esquiree/Raspberry_Pi_Hat/Temple_RPi_HAT Rev 3.1/JLCSMT_Sample_BOM1 (1).xlsx

Comment | Designator | Footprint | LCSC Part #（optional）
0.01uF | C6 C7 C14 C15 C16 C21 C24 C29 | C_0603 | C57112
0.1uF | C1 C4 C5 C13 C22 C25 C28 | C_0603 | C14663 (https://lcsc.com/product-detail/Multilayer-Ceramic-Capacitors-MLCC-SMD-SMT_100nF-104-10-50V_C14663.html/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)
1uF | C2 C3 C8 C9 C12 C17 C18 C19 C20 C23 C26 C27 | C_0603 | C15849 (https://lcsc.com/product-detail/Multilayer-Ceramic-Capacitors-MLCC-SMD-SMT_SAMSUNG_CL10A105KB8NNNC_1uF-105-10-50V_C15849.html/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)
47uF | C10 C11 | CP_Elec_5x5.3 | C134798
D | D4 D5 D8 | D_SMA | C22452
LED | D1 D2 D3 D6 D7 D9 D10 D11 | LED_0805 | C2297
Polyfuse | F1 | R_1812 | C69689
1.5K | R29 R34 | R_0603 | C21190
10 | R48 | R_0603 | C22773
100K | R44 | R_0603 | C23266 (https://lcsc.com/product-detail/Chip-Resistor-Surface-Mount_UNI-ROYAL-Uniroyal-Elec-0603WAF9312T5E_C23266.html)
13.5K | R31 | R_0603 | C25952
1K | R1 R2 R3 R4 R5 R8 R35 R37 R38 R39 R40 R41 R42 R43 R46 R47 | R_0603 | C21190
200K | R30 R32 R45 | R_0603 | C8218
27K | R33 | R_0603 | C22967
2K | R36 | R_0603 | C22975
AZ1117-3.3 | U8 | SOT-223-3_TabPin2 | C369933
BQ24092DGQR | U6 | MSOP-10-1EP_3x3mm_Pitch0.5mm | C133237
DRV8833RTYR | U9 U10 | WQFN-16-1EP_4x4mm_Pitch0.65mm_ThermalVias | C154936
LMV321 | U7 | SOT-23-5 | C7972
LSM6DS3 | U1 | Bosch_LGA-16 | C95231 (https://lcsc.com/product-detail/Sensors_STMicroelectronics_LSM6DS33TR_LSM6DS33TR_C95231.html/?href=jlc-SMT)
SY7304DBC | U4 U5 | DFN-10-1EP_3x3mm_Pitch0.5mm | C178252
