esquiree/Raspberry_Pi_Hat/Temple_RPi_HAT Rev 3.1/Temple_RPi_HAT.pdf

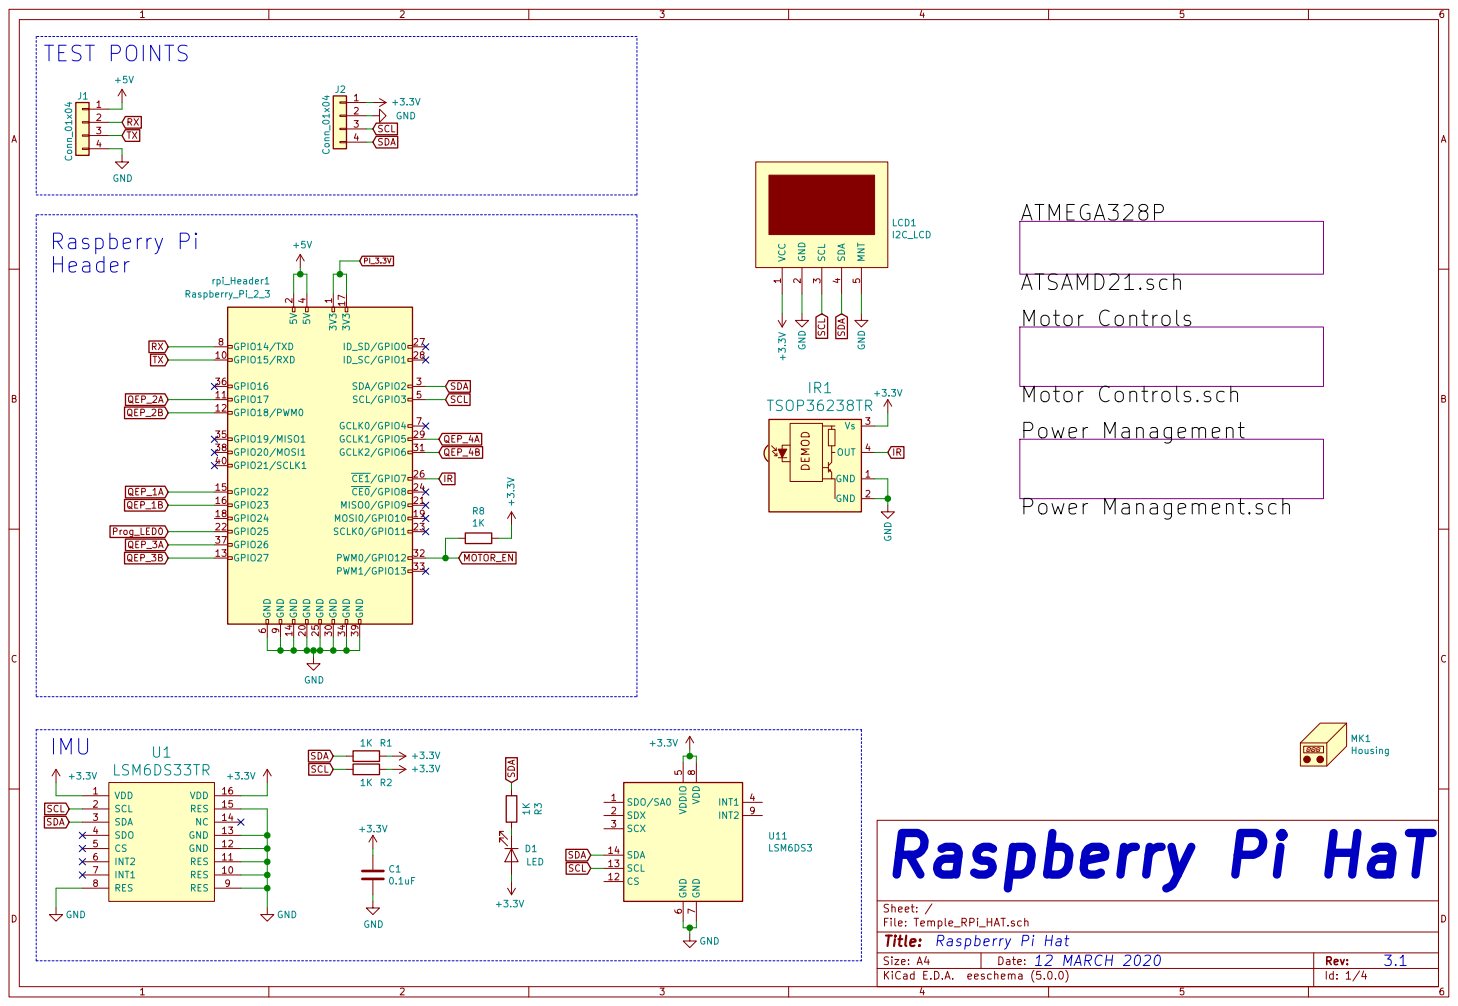
[picture p1: page 1]

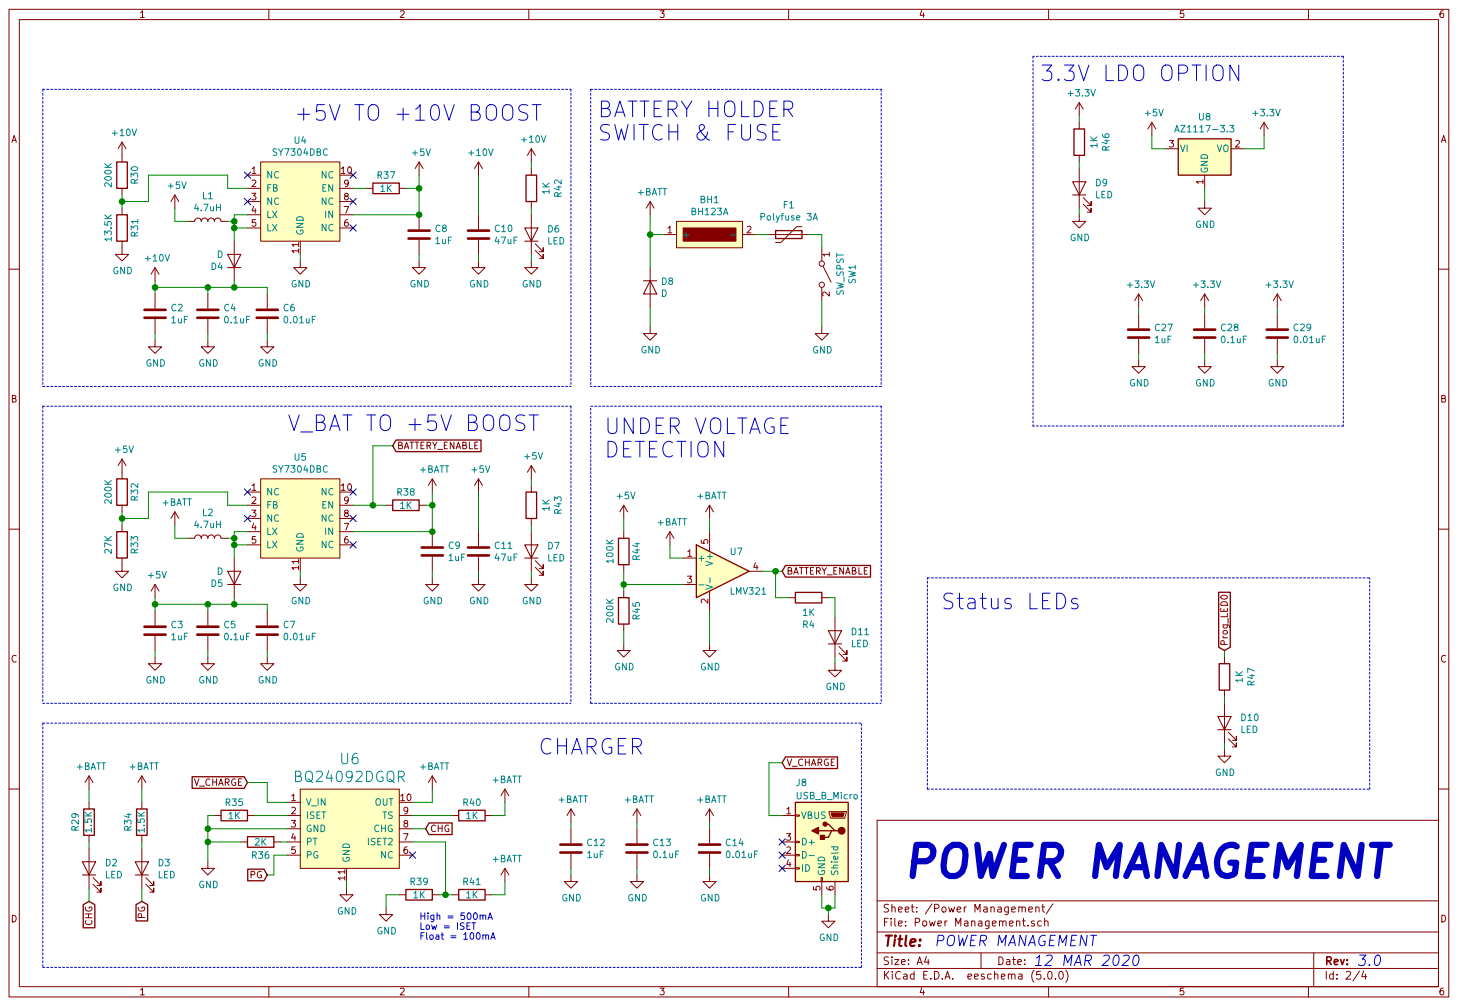
[picture p2: page 2]

Sheet: /Power Management/
File: Power Management.sch
POWER MANAGEMENT

High = 500mA

12 MAR 2020

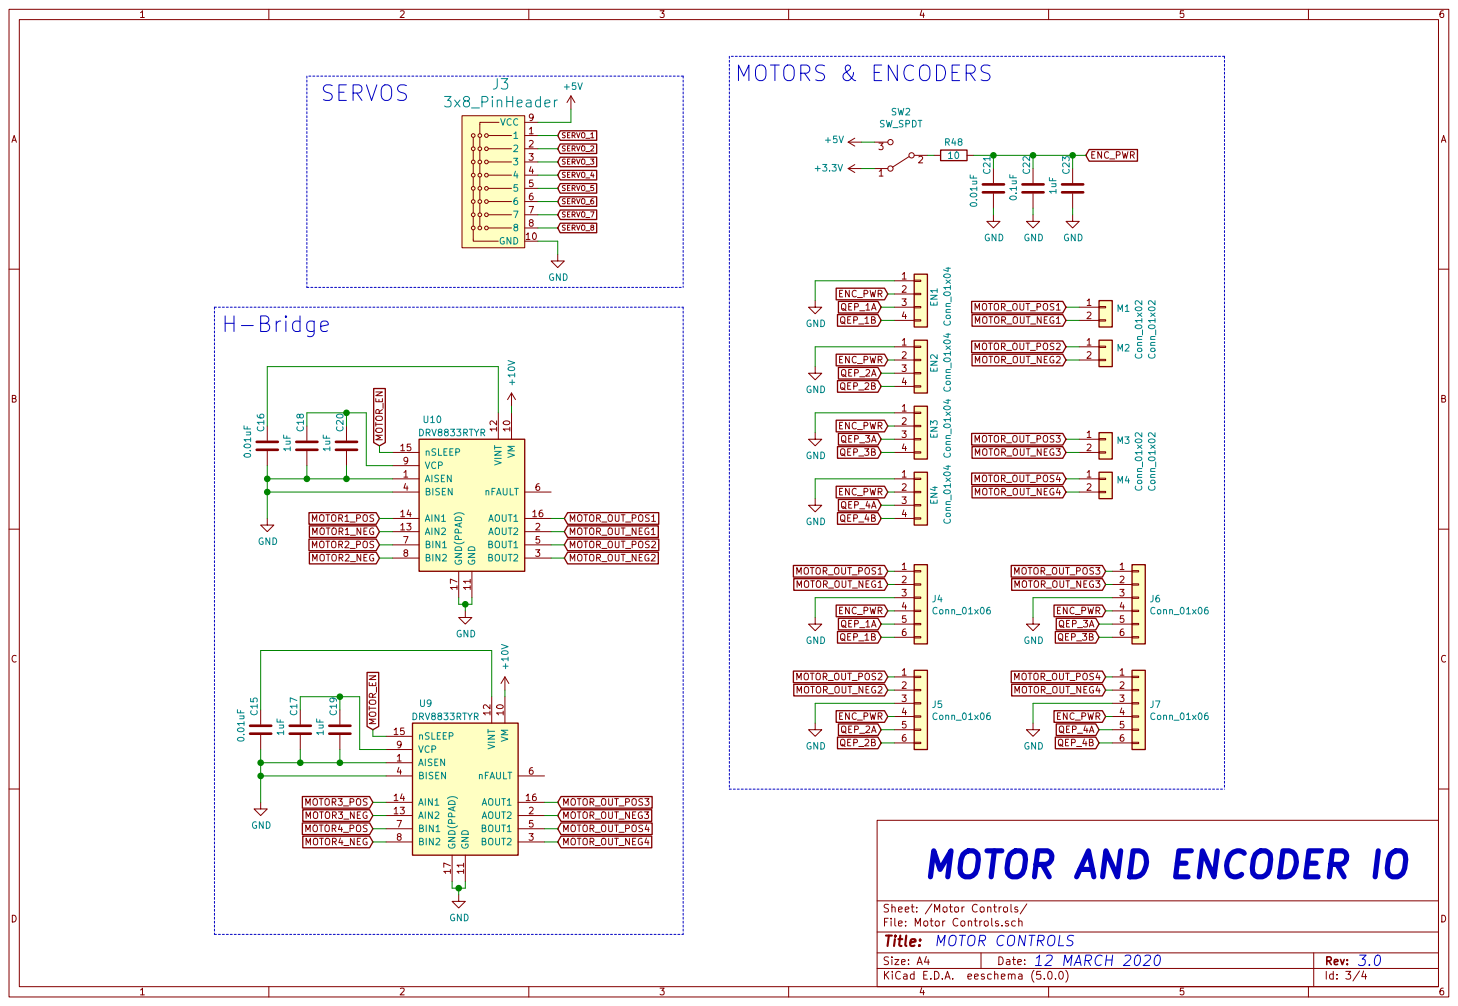
[picture p3: page 3]

MOTOR AND ENCODER IO

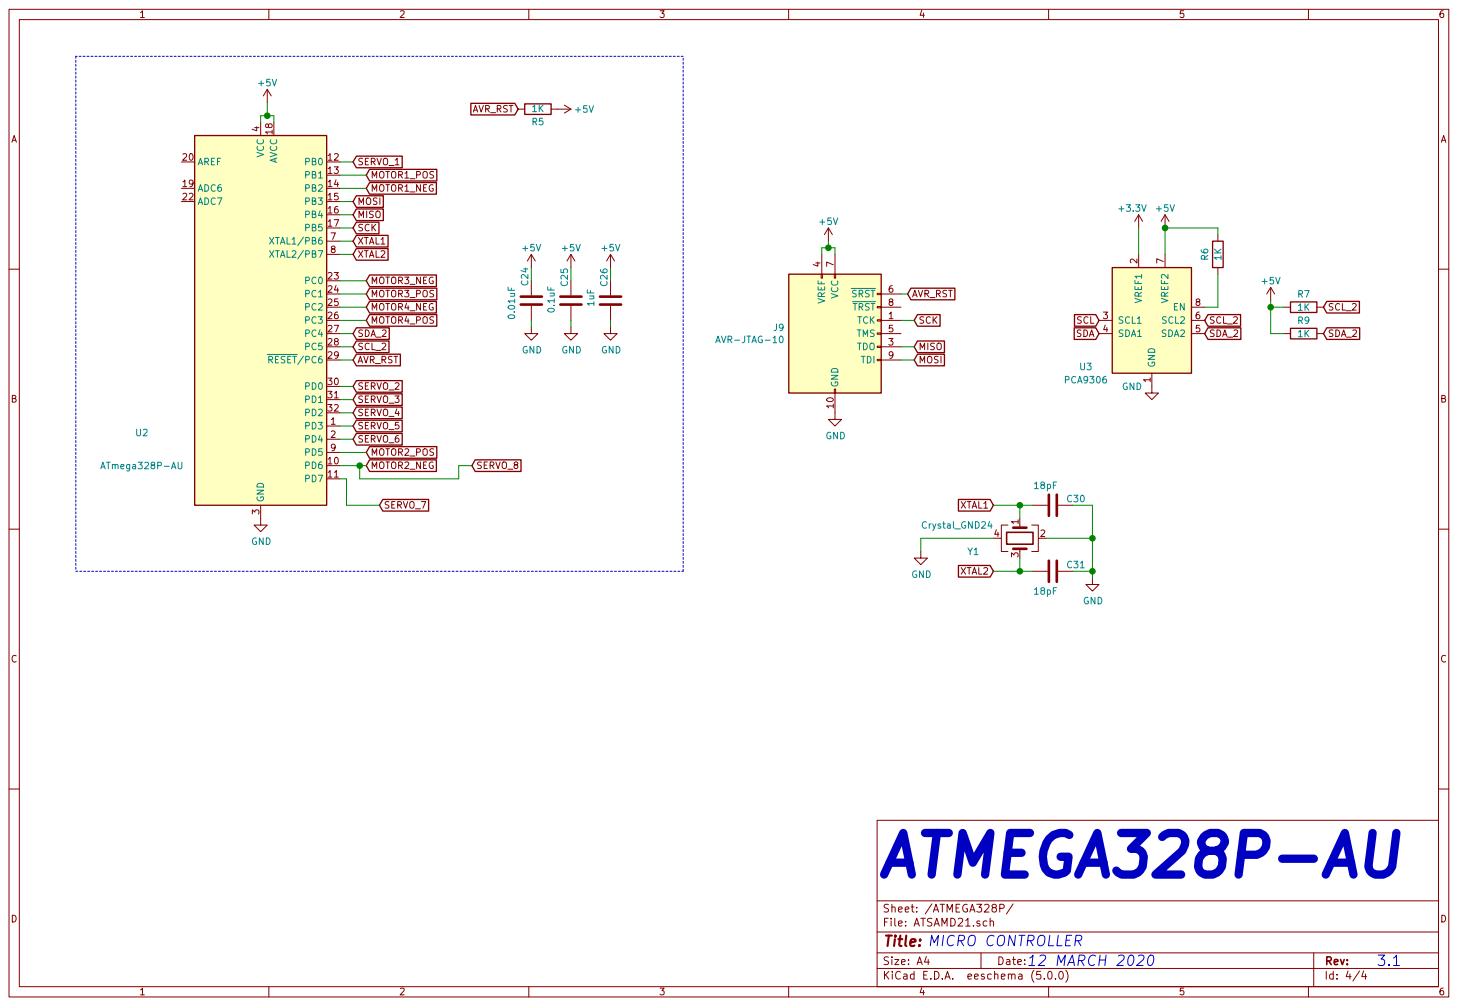
[picture p4: page 4]

Id: 4/4 Title: File: ATSAMD21.sch Sheet: /ATMEGA328P/
MICRO CONTROLLER
