esquiree/Raspberry_Pi_Hat/Temple_RPi_HAT Rev 3.0/Temple_RPi_HAT.pdf

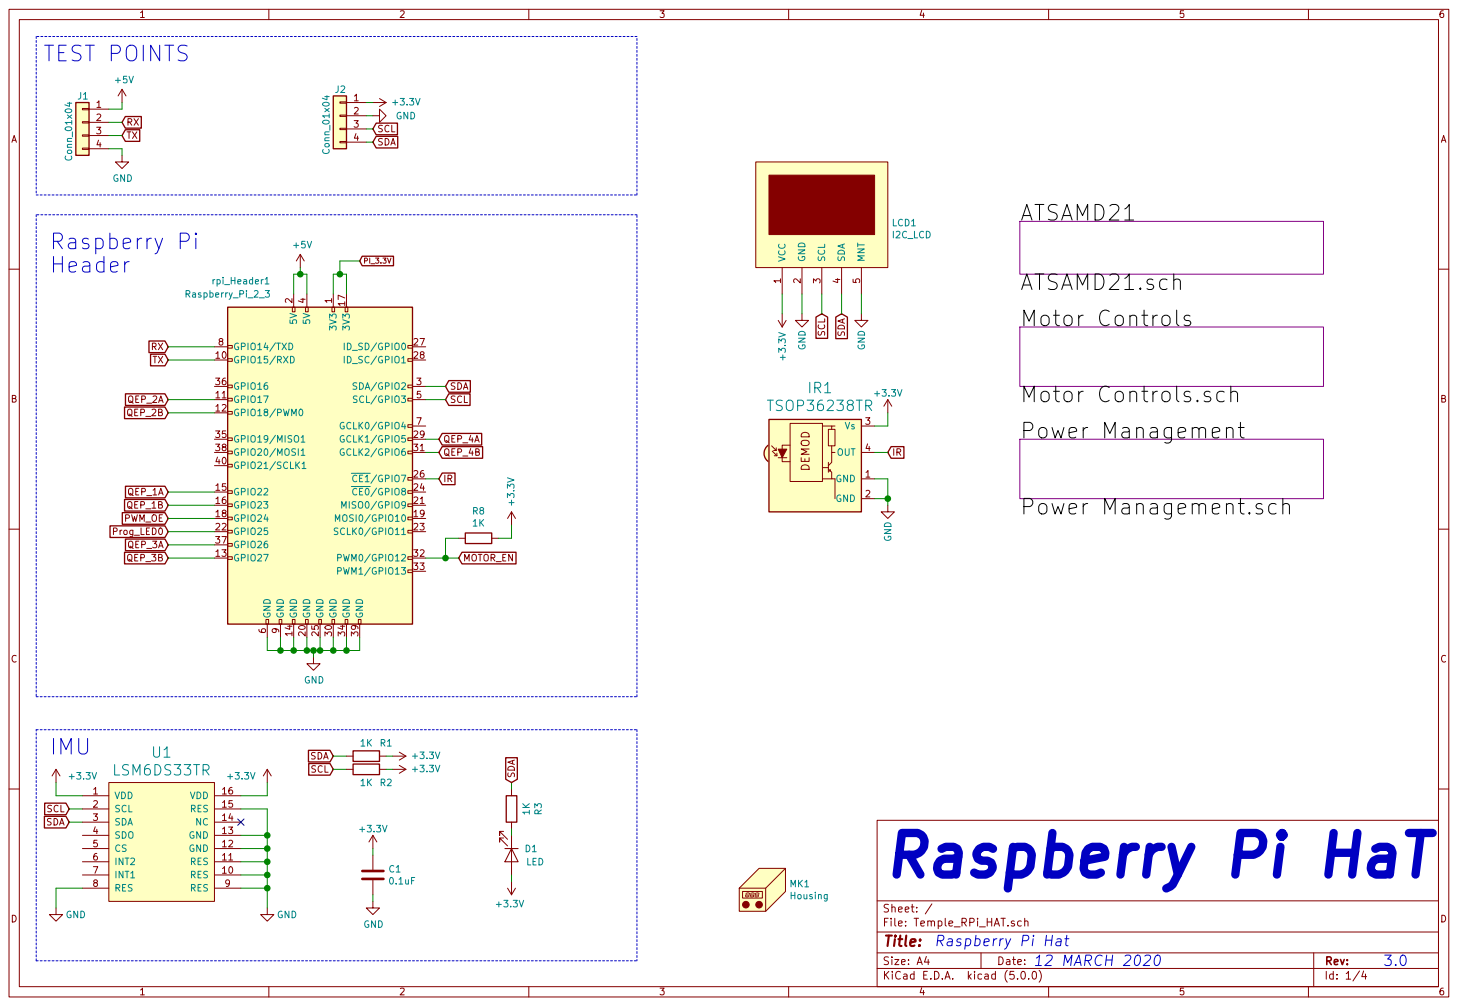
[picture p5: page 1]

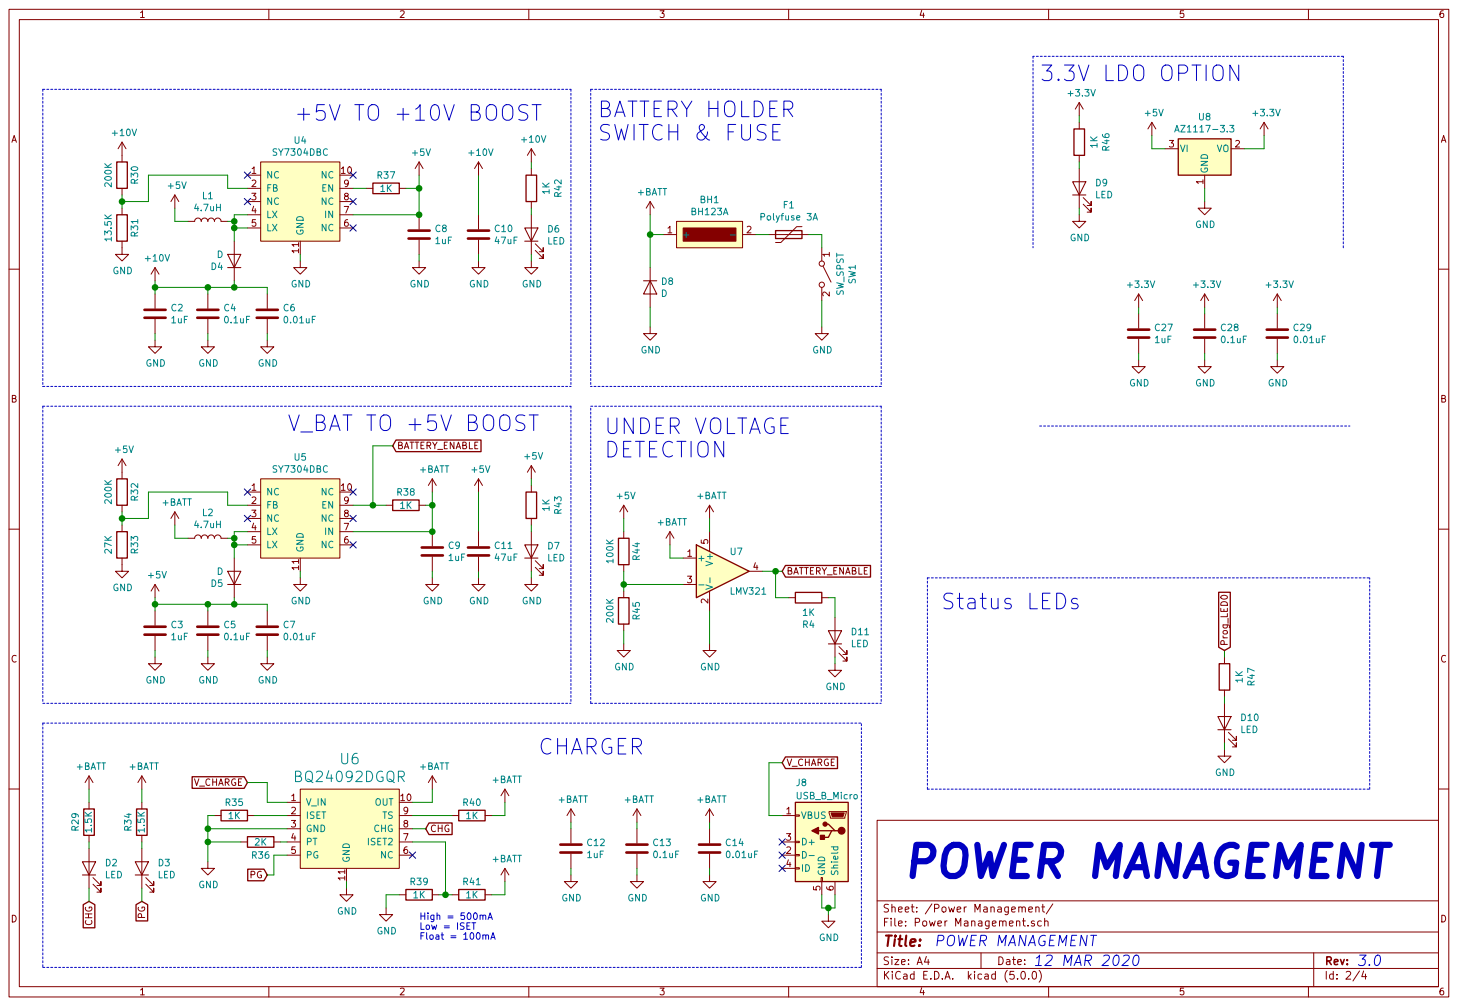
[picture p6: page 2]

Sheet: /Power Management/
File: Power Management.sch
POWER MANAGEMENT

High = 500mA

12 MAR 2020

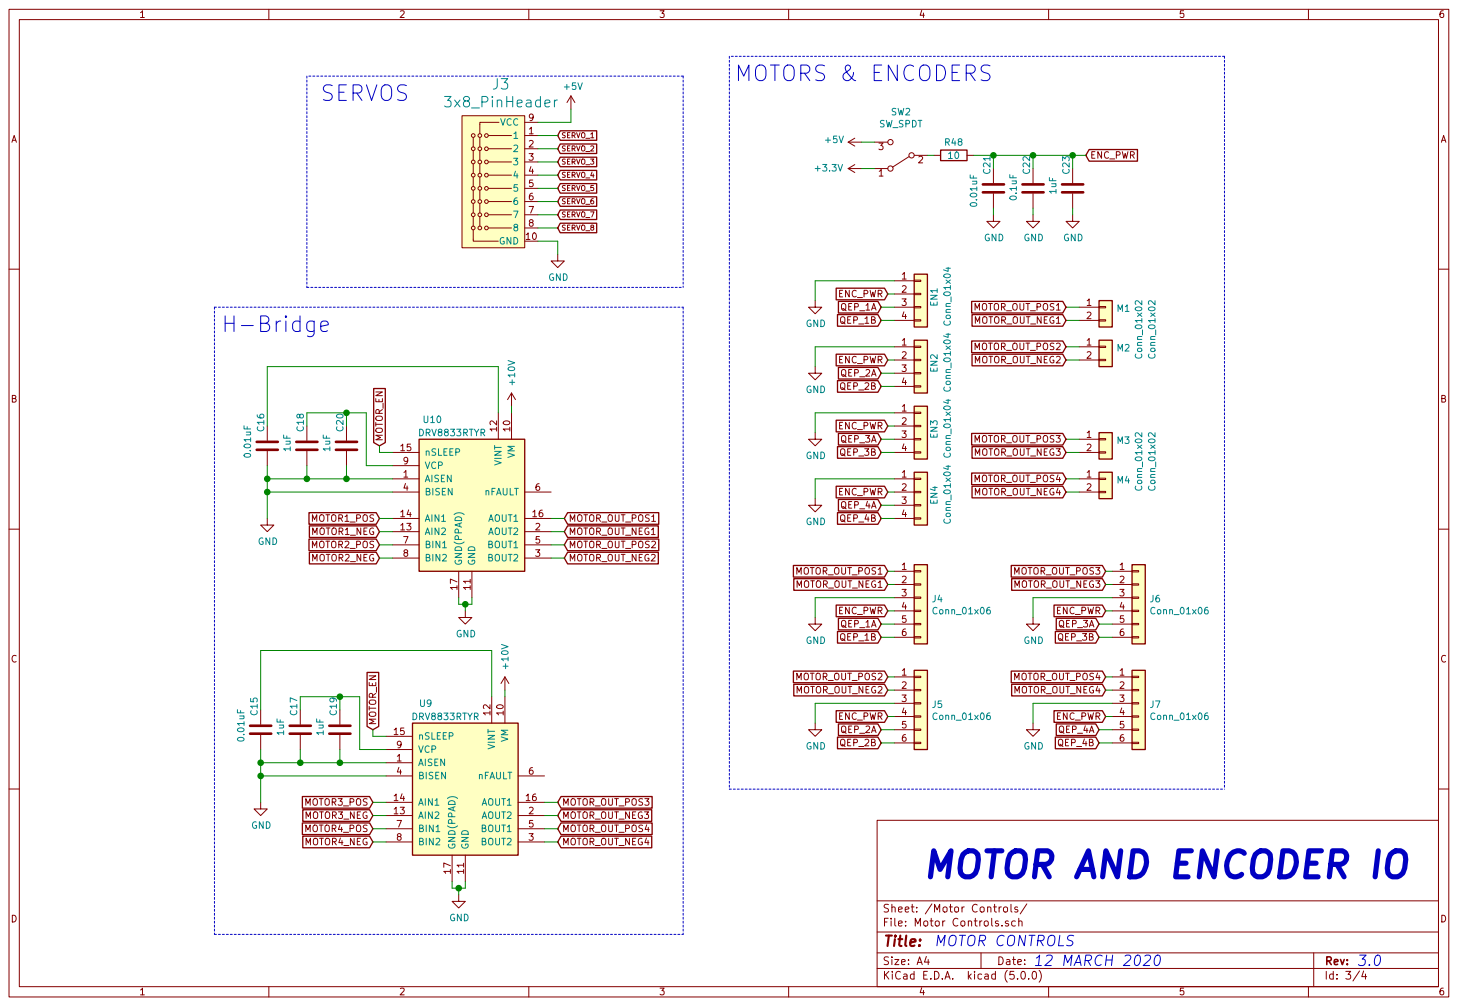
[picture p7: page 3]

MOTOR AND ENCODER IO

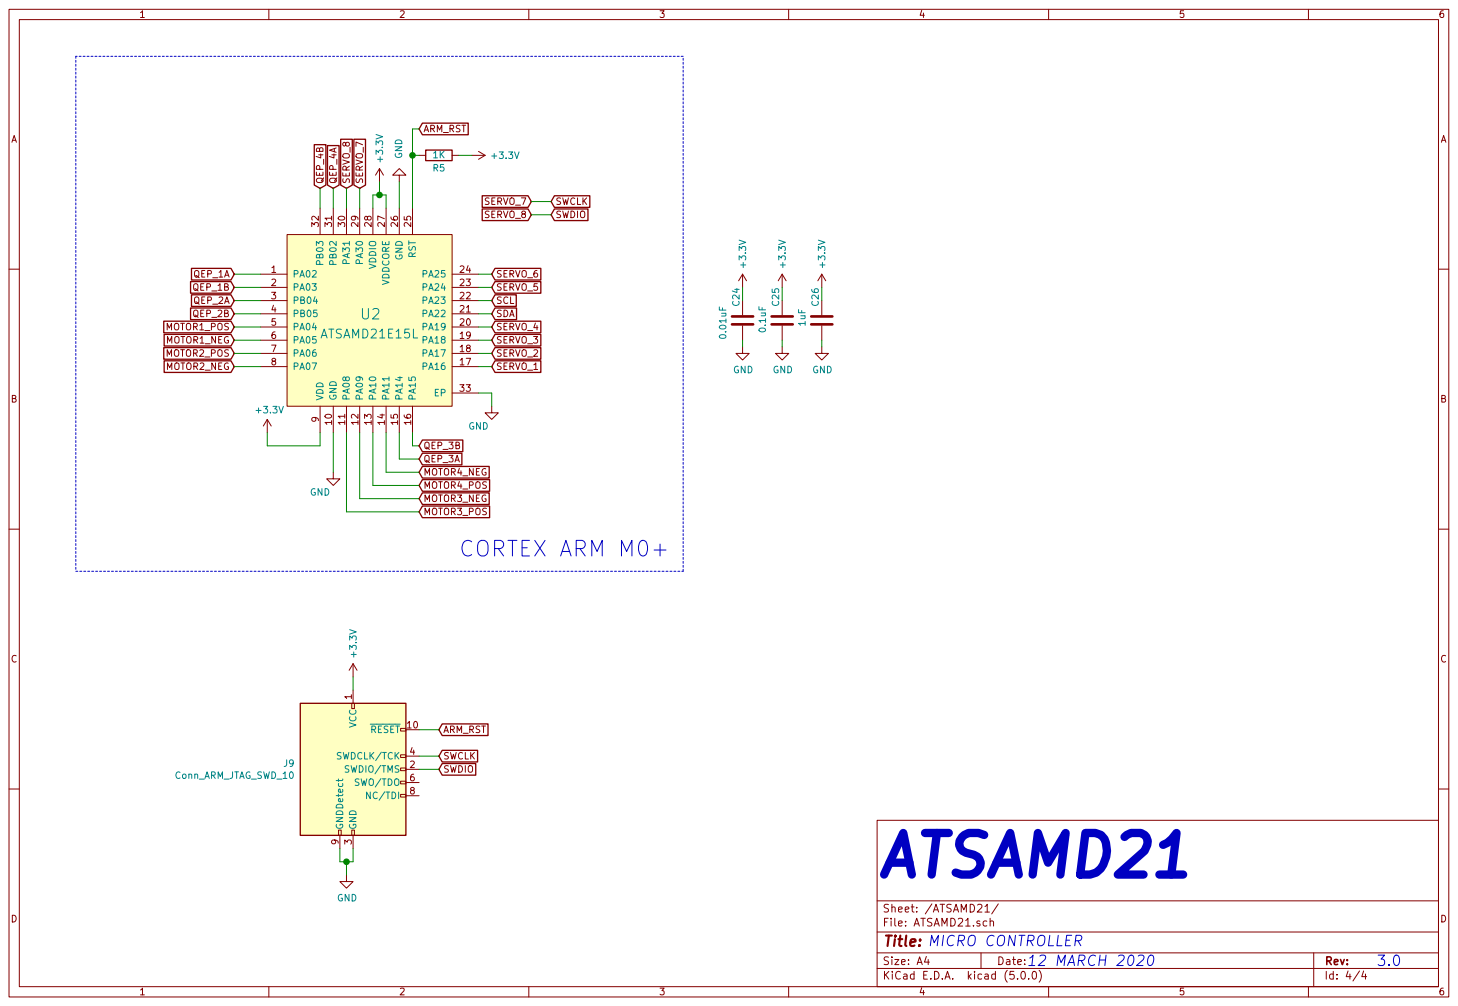
[picture p8: page 4]

1 RESET 10 SWDIO/TMS 2 GND

3 SWDCLK/TCK 4 SWO/TDO 6 NC/TDI 8 GNDDetect 9

Id: 4/4 Title: File: ATSAMD21.sch Sheet: /ATSAMD21/
MICRO CONTROLLER
