esquiree/Raspberry_Pi_Hat/Temple_RPi_HAT Rev 3.1/Temple_RPi_HAT.kicad_pcb

## KiCad design Temple_RPi_HAT Rev 3.1/Temple_RPi_HAT.kicad_pcb (2020-08-13)

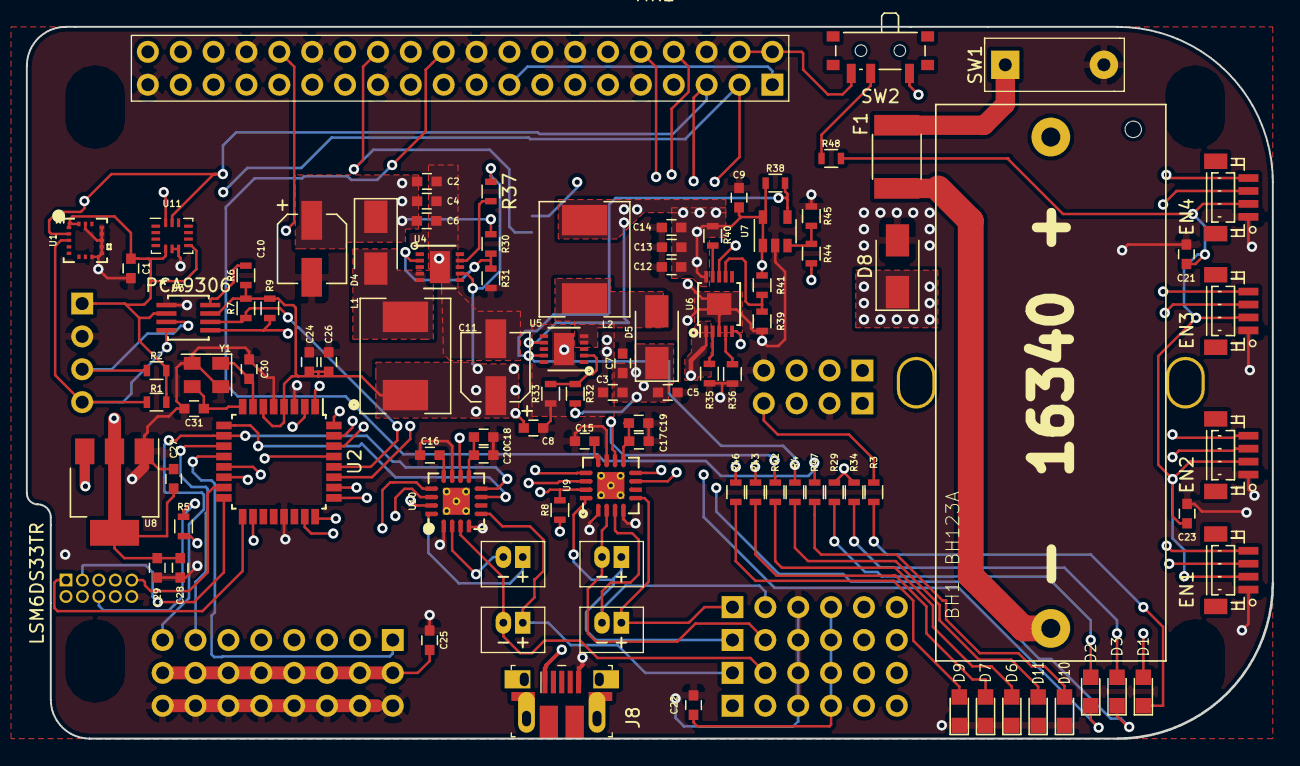
[picture p9: board Temple_RPi_HAT.kicad_pcb from above]

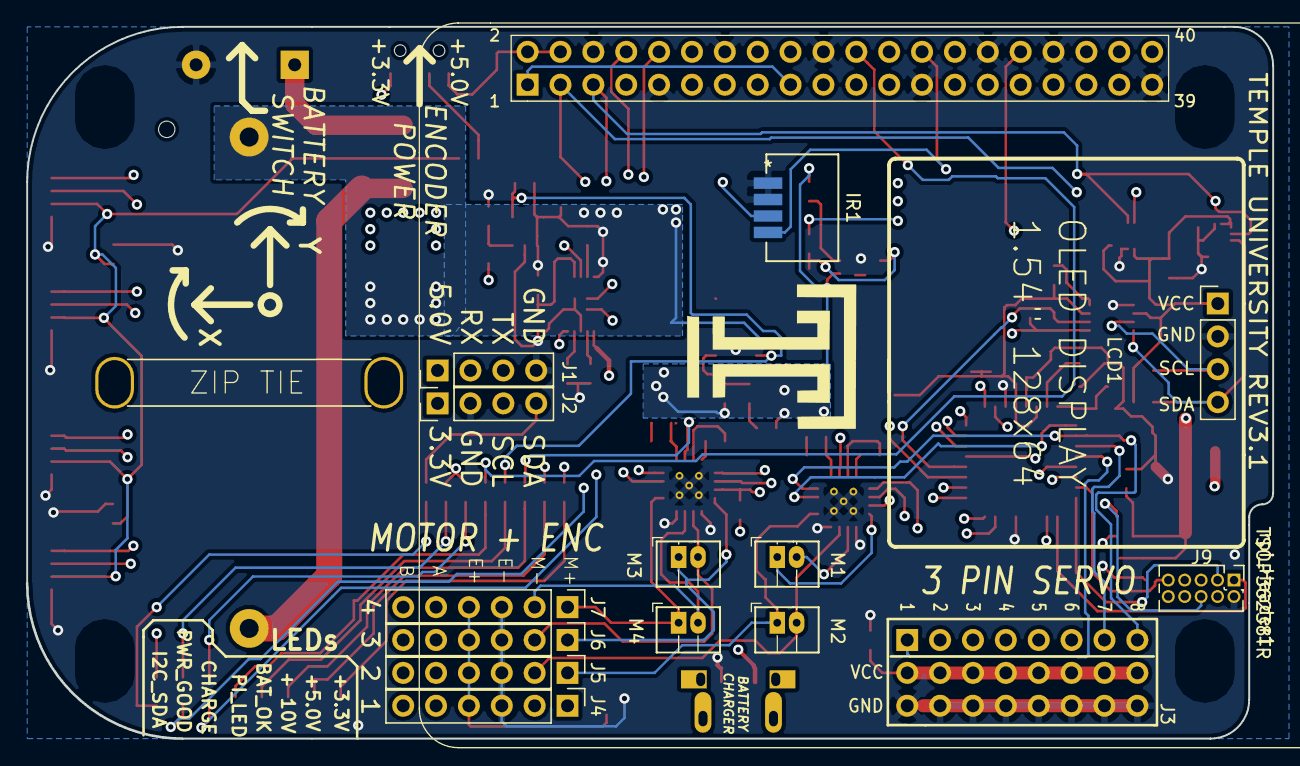
[picture p10: board Temple_RPi_HAT.kicad_pcb from below]

Board: 4 copper layers, 96.3 x 55.0 mm, 110 parts (15 on the bottom side), 83 nets.

Parts:
BH1: BH123A; BAT_BH123A
C1, C4, C5, C13, C22, C25, C28: 0.1uF; C_0603
C2, C3, C8, C9, C12, C17, C18, C19, C20, C23, C26, C27: 1uF; C_0603
C6, C7, C14, C15, C16, C21, C24, C29: 0.01uF; C_0603
C10, C11: 47uF; CP_Elec_5x5.3
C30, C31: 18pF; C_0603
D1, D2, D3, D6, D7, D9, D10, D11: LED; LED_0805
D4, D5, D8: D; D_SMA
EN1, EN2, EN3, EN4: Conn_01x04; JST_SH_BM04B-SRSS-TB_04x1.00mm_Straight
F1: Polyfuse 3A; R_1812
IR1: TSOP36238TR
J1, J2: Conn_01x04; Pin_Header_Straight_1x04_Pitch2.54mm
J3: 3x8_PinHeader; 3X8_PINHEADER
J4, J5, J6, J7: Conn_01x06; Pin_Header_Straight_1x06_Pitch2.54mm
J8: USB_B_Micro; USB_Micro_B_Female_10103594-0001LF
J9: AVR-JTAG-10; Pin_Header_Straight_2x05_Pitch1.27mm
L1, L2: 4.7uH; L_7.3x6.8
LCD1: I2C_LCD; SSD1306_NO_BOTTOM_SILK_NO_MOUNT
M1, M2, M3, M4: Conn_01x02; 1_5MM ZH JST
MK1: Housing; BeagleBoneBlue_Extended_2cm
R1, R2, R3, R4, R5, R6, R7, R8, R9, R35, R37, R38, R39, R40, R41, R42, R43, R46, R47: 1K; R_0603
R29, R34: 1.5K; R_0603
R30, R32, R45: 200K; R_0603
R31: 13.5K; R_0603
R33: 27K; R_0603
R36: 2K; R_0603
R44: 100K; R_0603
R48: 10; R_0603
SW1: SW_SPST; Single Dip Siwtch
SW2: SW_SPDT; SW_SPDT_PCM12
U1: LSM6DS33TR
U2: ATmega328P-AU; LQFP-32_7x7mm_Pitch0.8mm
U3: PCA9306; PCA9306DCTR
U4, U5: SY7304DBC; DFN-10-1EP_3x3mm_Pitch0.5mm
U6: BQ24092DGQR; MSOP-10-1EP_3x3mm_Pitch0.5mm
U7: LMV321; SOT-23-5
U8: AZ1117-3.3; SOT-223-3_TabPin2
U9, U10: DRV8833RTYR; WQFN-16-1EP_4x4mm_Pitch0.65mm_ThermalVias
U11: LSM6DS3; Bosch_LGA-14_3x2.5mm_Pitch0.5mm
Y1: Crystal_GND24; Crystal_SMD_EuroQuartz_MT-4pin_3.2x2.5mm
rpi_Header1: Raspberry_Pi_2_3; RaspberryPi_No Holes

Connections:
+3V3: C1.1, C27.1, C28.1, C29.1, D1.2, IR1.3, J2.1, LCD1.1, R1.2, R2.2, R8.1, R46.2, SW2.1, U1.1, U1.16, U3.2, U8.2, U11.5, U11.8
+5V: C3.1, C5.1, C7.1, C8.1, C11.1, C24.1, C25.1, C26.1, D5.1, J1.1, J3.9, J9.4, J9.7, L1.1, R5.1, R6.2, R7.1, R9.1, R32.2, R37.1, R43.2, R44.2, SW2.3, U2.4, U2.6, U2.18, U3.7, U4.7, U8.3, rpi_Header1.2, rpi_Header1.4
+10V: C2.1, C4.1, C6.1, C10.1, D4.1, R30.2, R42.2, U9.10, U10.10
+BATT: BH1.1, C9.1, C12.1, C13.1, C14.1, D8.1, L2.1, R29.2, R34.2, R38.1, R40.1, R41.1, U5.7, U6.10, U7.1, U7.5
AVR_RST: J9.6, R5.2, U2.29
BATTERY_ENABLE: R4.1, R38.2, U5.9, U7.4
CHG: D2.1, U6.8
ENC_PWR: C21.1, C22.1, C23.1, EN1.2, EN2.2, EN3.2, EN4.2, J4.4, J5.4, J6.4, J7.4, R48.2
GND: C1.2, C2.2, C3.2, C4.2, C5.2, C6.2, C7.2, C8.2, C9.2, C10.2, C11.2, C12.2, C13.2, C14.2, C15.2, C16.2, C17.2, C18.2, C19.2, C20.2, C21.2, C22.2, C23.2, C24.2, C25.2, C26.2, C27.2, C28.2, C29.2, C30.1, C31.1, D6.1, D7.1, D8.2, D9.1, D10.1, D11.1, EN1.1, EN2.1, EN3.1, EN4.1, IR1.1, IR1.2, J1.4, J2.2, J3.10, J4.3, J5.3, J6.3, J7.3, J8.5, J9.2, J9.10, LCD1.2, R31.1, R33.1, R35.2, R36.2, R39.2, R45.1, SW1.2, U1.8, U1.9, U1.10, U1.11, U1.12, U1.13, U1.15, U2.3, U2.5, U2.21, U3.1, U4.11, U5.11, U6.3, U6.11, U7.2, U8.1, U9.1, U9.4, U9.11, U9.17, U10.1, U10.4, U10.11, U10.17, U11.6, U11.7, Y1.2, Y1.4, rpi_Header1.6, rpi_Header1.9, rpi_Header1.14, rpi_Header1.20, rpi_Header1.25, rpi_Header1.30, rpi_Header1.34, rpi_Header1.39
IR: IR1.4, rpi_Header1.26
MISO: J9.3, U2.16
MOSI: J9.9, U2.15
MOTOR1_NEG: U2.14, U10.13
MOTOR1_POS: U2.13, U10.14
MOTOR2_NEG: J3.8, U2.10, U10.8
MOTOR2_POS: U2.9, U10.7
MOTOR3_NEG: U2.23, U9.13
MOTOR3_POS: U2.24, U9.14
MOTOR4_NEG: U2.25, U9.8
MOTOR4_POS: U2.26, U9.7
MOTOR_EN: R8.2, U9.15, U10.15, rpi_Header1.32
MOTOR_OUT_NEG1: J4.2, M1.2, U10.2
MOTOR_OUT_NEG2: J5.2, M2.2, U10.3
MOTOR_OUT_NEG3: J6.2, M3.2, U9.2
MOTOR_OUT_NEG4: J7.2, M4.2, U9.3
MOTOR_OUT_POS1: J4.1, M1.1, U10.16
MOTOR_OUT_POS2: J5.1, M2.1, U10.5
MOTOR_OUT_POS3: J6.1, M3.1, U9.16
MOTOR_OUT_POS4: J7.1, M4.1, U9.5
unnamed: BH1.2, F1.2
unnamed: C15.1, U9.12
unnamed: C16.1, U10.12
unnamed: C17.1, C19.1, U9.9
unnamed: C18.1, C20.1, U10.9
unnamed: D1.1, R3.1
unnamed: D2.2, R29.1
unnamed: D3.2, R34.1
unnamed: D4.2, L1.2, U4.4, U4.5
unnamed: D5.2, L2.2, U5.4, U5.5
unnamed: D6.2, R42.1
unnamed: D7.2, R43.1
unnamed: D9.2, R46.1
unnamed: D10.2, R47.1
unnamed: D11.2, R4.2
unnamed: F1.1, SW1.1
unnamed: R6.1, U3.8
unnamed: R30.1, R31.2, U4.2
unnamed: R32.1, R33.2, U5.2
unnamed: R35.1, U6.2
unnamed: R36.1, U6.4
unnamed: R37.2, U4.9
unnamed: R39.1, R41.2, U6.7
unnamed: R40.2, U6.9
unnamed: R44.1, R45.2, U7.3
unnamed: R48.1, SW2.2
PG: D3.1, U6.5
PI_3.3V: rpi_Header1.1, rpi_Header1.17
Prog_LED0: R47.2, rpi_Header1.22
QEP_1A: EN1.3, J4.5, rpi_Header1.15
QEP_1B: EN1.4, J4.6, rpi_Header1.16
QEP_2A: EN2.3, J5.5, rpi_Header1.11
QEP_2B: EN2.4, J5.6, rpi_Header1.12
QEP_3A: EN3.3, J6.5, rpi_Header1.37
QEP_3B: EN3.4, J6.6, rpi_Header1.13
QEP_4A: EN4.3, J7.5, rpi_Header1.29
QEP_4B: EN4.4, J7.6, rpi_Header1.31
RX: J1.2, rpi_Header1.8
SCK: J9.1, U2.17
SCL: J2.3, LCD1.3, R2.1, U1.2, U3.3, U11.13, rpi_Header1.5
SCL_2: R7.2, U2.28, U3.6
SDA: J2.4, LCD1.4, R1.1, R3.2, U1.3, U3.4, U11.14, rpi_Header1.3
SDA_2: R9.2, U2.27, U3.5
SERVO_1: J3.1, U2.12
SERVO_2: J3.2, U2.30
SERVO_3: J3.3, U2.31
SERVO_4: J3.4, U2.32
SERVO_5: J3.5, U2.1
SERVO_6: J3.6, U2.2
SERVO_7: J3.7, U2.11
TX: J1.3, rpi_Header1.10
V_CHARGE: J8.1, U6.1
XTAL1: C30.2, U2.7, Y1.1
XTAL2: C31.2, U2.8, Y1.3
